greyboxaudio/SIAM-295b/README.md

# SIAM 295b
This design is based on the Siemens W295b Equalizer.
