greyboxaudio/SIAM-295b/SIAM-295b/SIAM-295b.pdf

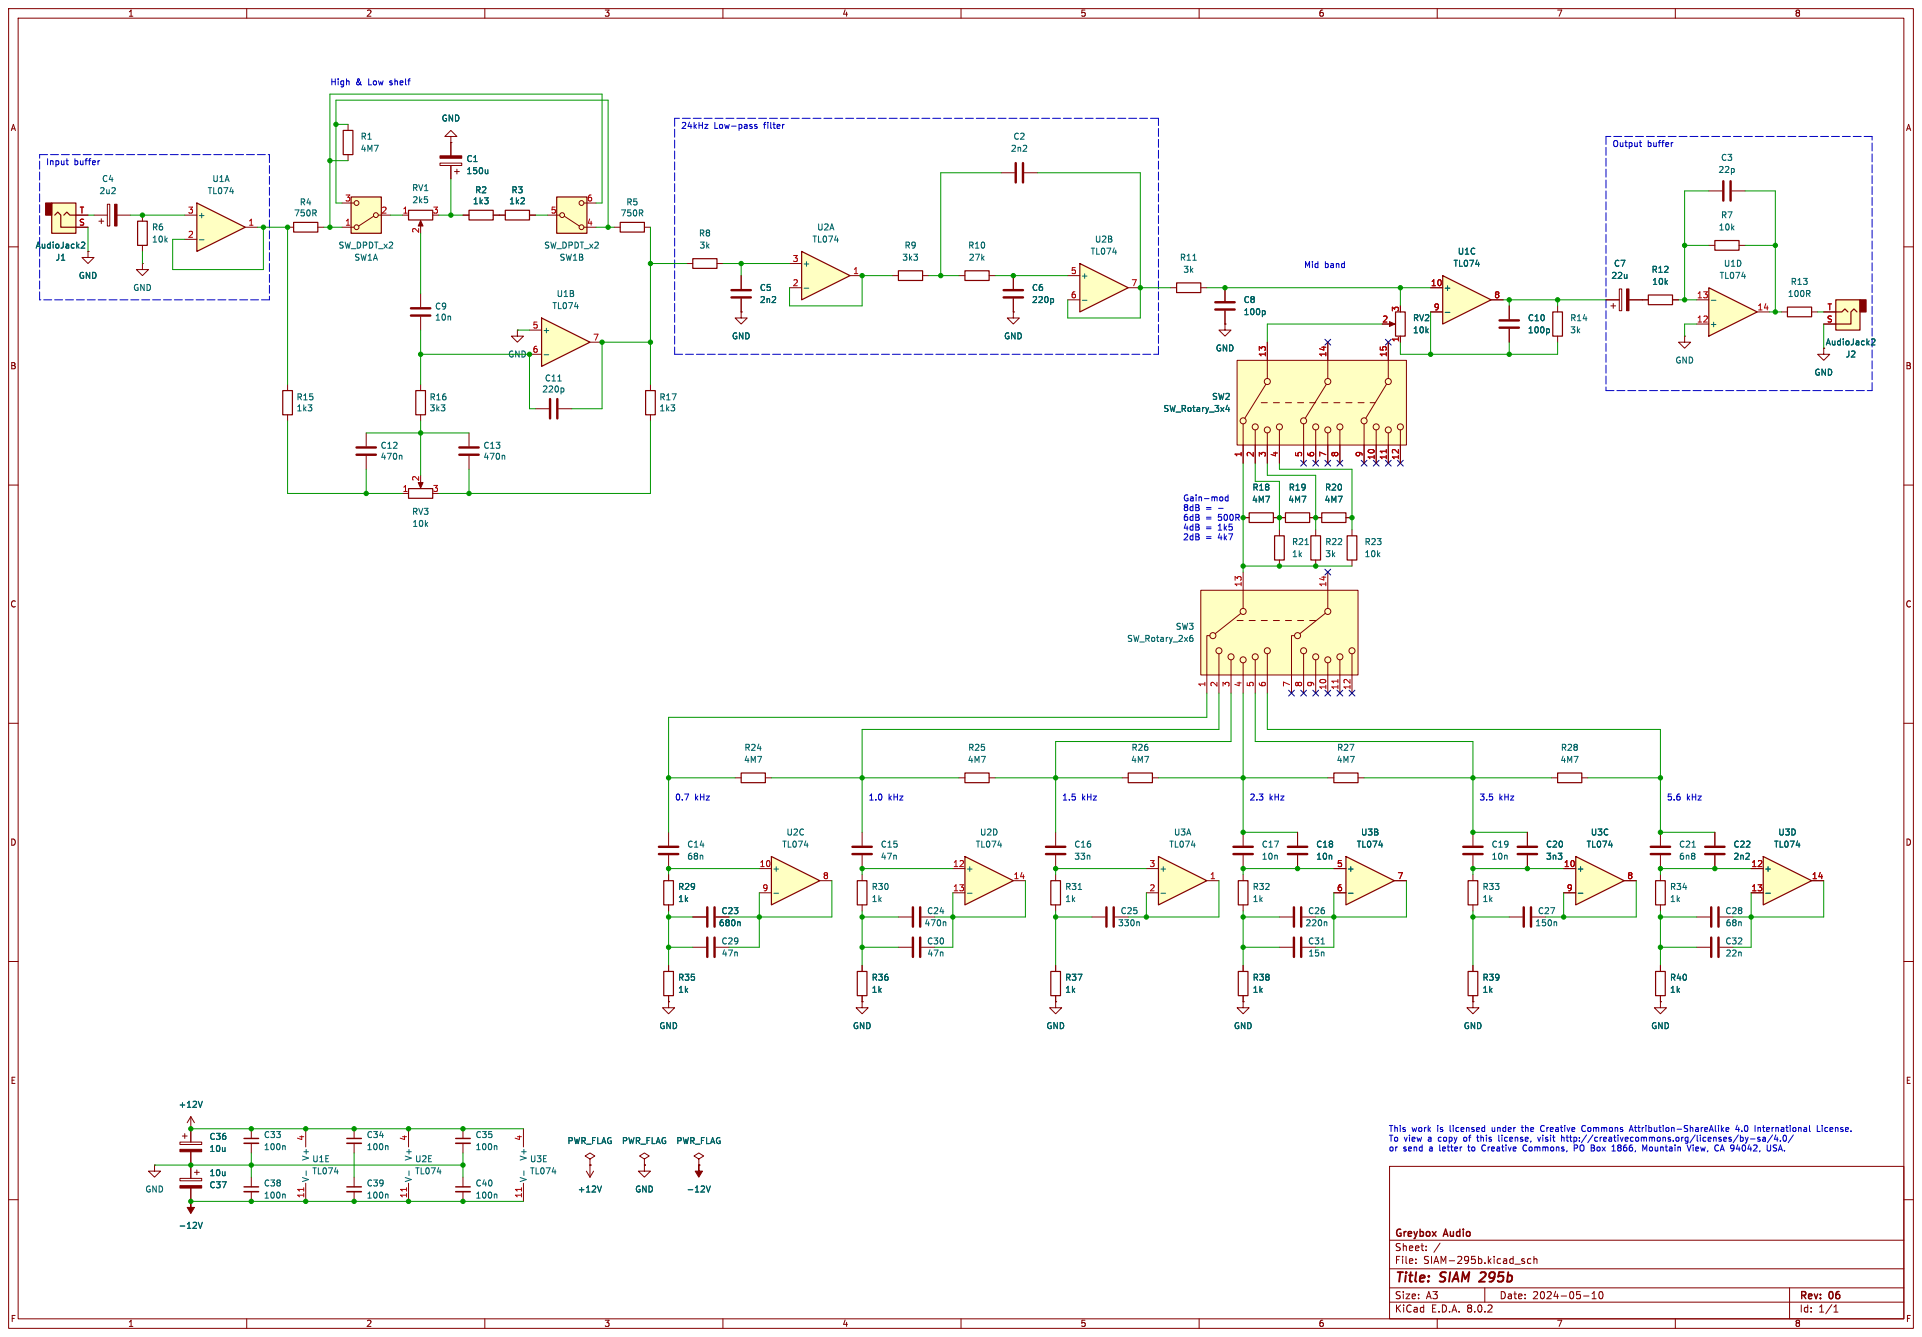
[picture p1: page 1]

File: SIAM-295b.kicad_sch Sheet: / Greybox Audio
