greyboxaudio/SIAM-295b/SIAM-295b/ClassA/siemens/siemens.pdf

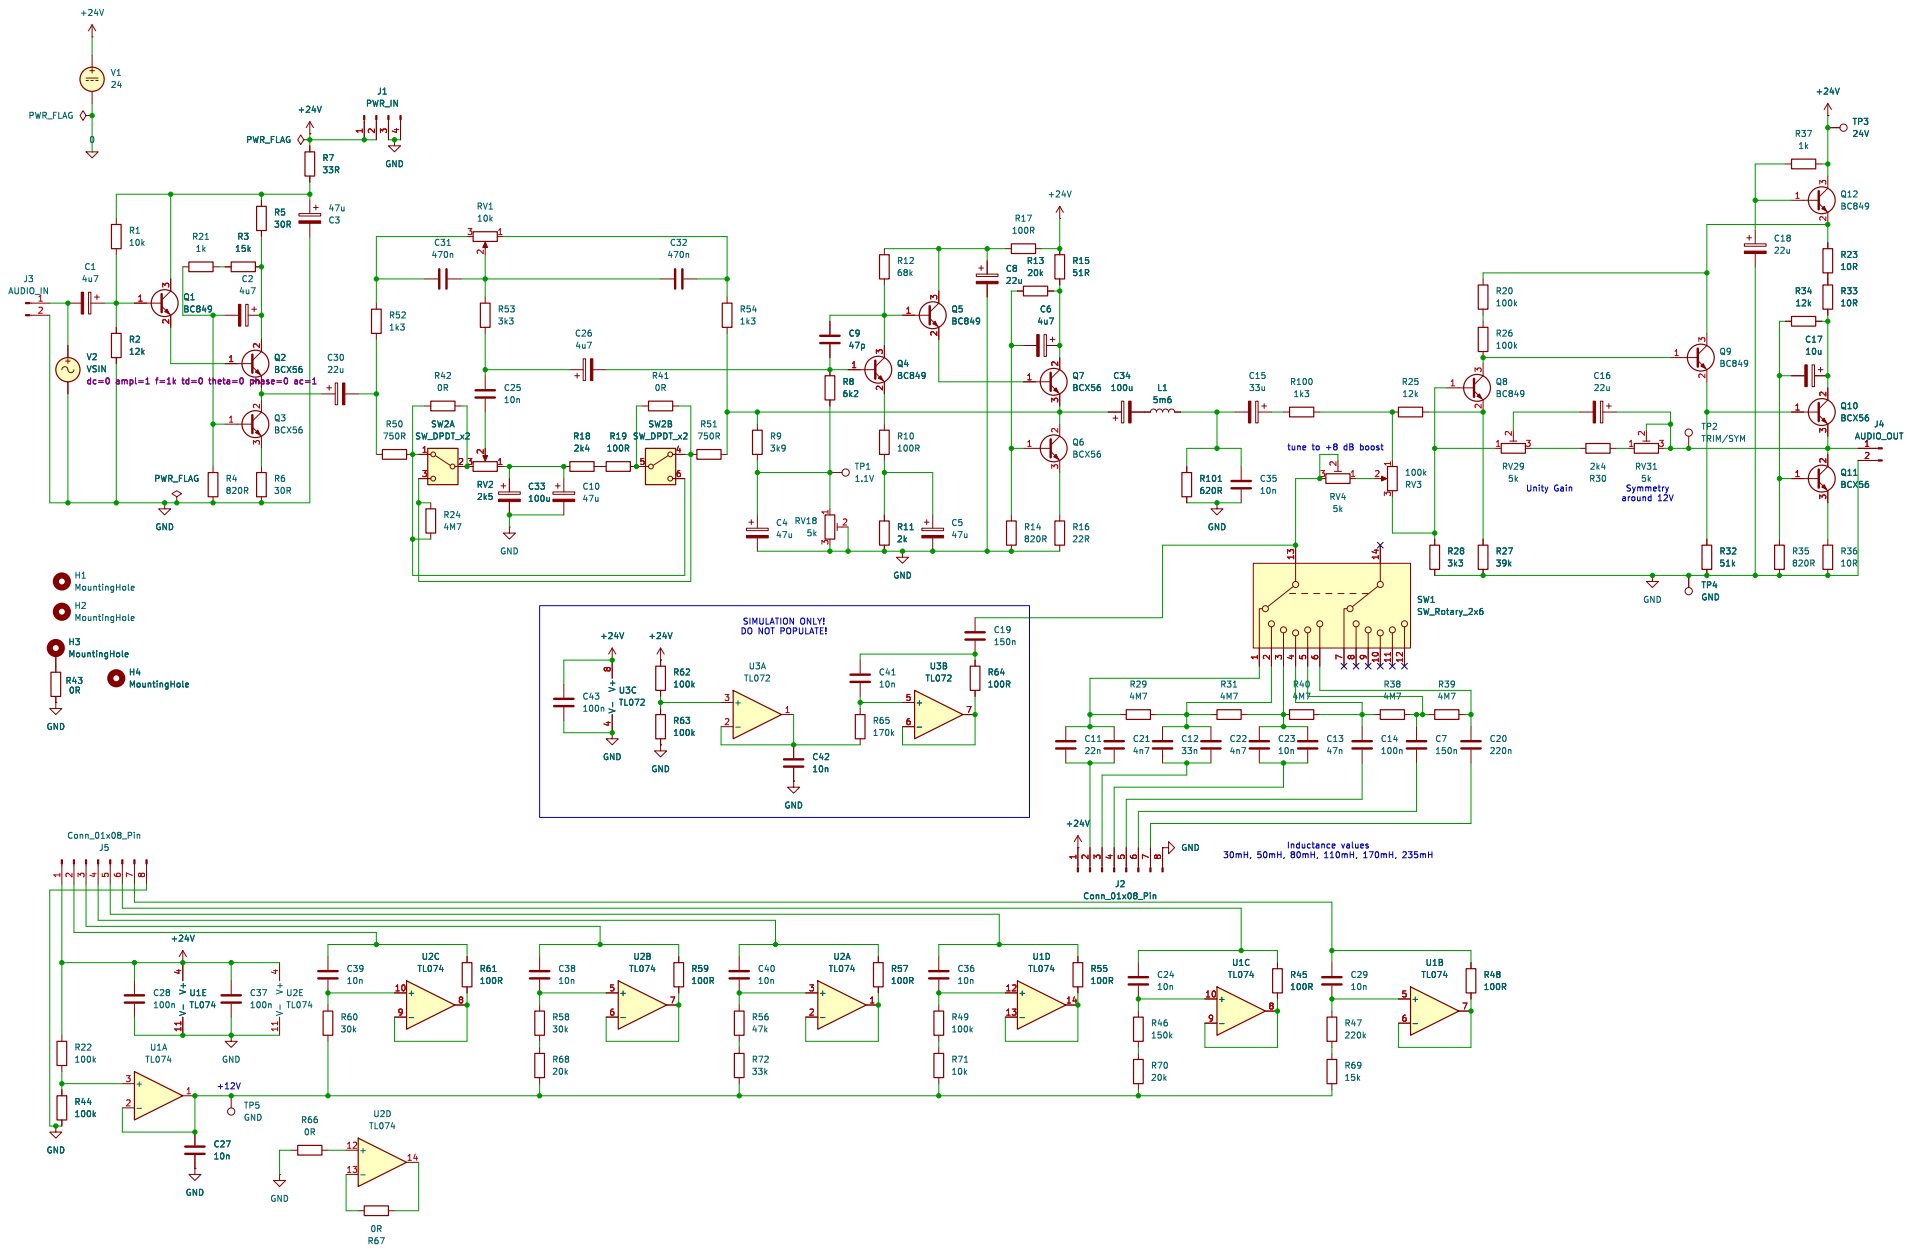
[picture p2: page 1]

tune to +8 dB boost
