greyboxaudio/SIAM-295b/w295b.asc

C1: cap; 4µ7
C2: cap; 56p
C3: cap; 100µ
C4: cap; 22µ
C5: cap; 56µ
C6: cap; 10n
C7: cap; 56µ
C8: cap; 150µ
C9: cap; 25µ
C10: cap; 22µ
C11: cap; 470n
C12: cap; 470n
C13: cap; 10µ
C14: cap; 22µ
C15: cap; 33µ
C16: cap; 10n
C17: cap; {C}
C18: cap; 4µ7
C19: cap; 50µ
C20: cap; 4µ7
C21: cap; 4µ7
C22: cap; 4µ7
C23: cap; 10n
C24: cap; 470n
C25: cap; 470n
C26: cap; 150µ
C27: cap; 2µ2
C28: cap; {C}
C30: cap; 100p
C31: cap; 100p
C32: cap; 220p
C33: cap; 22p
C34: cap; 22p
C35: cap; 2n2
C36: cap; 220p
C37: cap; 2n2
C38: cap; 22µ
C39: cap; {C1}
C40: cap; {C2}
L1: ind; {L}
L2: ind; 6m
L3: ind; {L}
Q1: npn
Q2: npn
Q3: npn
Q4: npn
Q5: npn
Q6: npn
Q7: npn
Q8: npn
Q9: npn
Q10: npn
Q11: npn
Q12: npn
R1: res; 6k2
R2: res; 3k9
R3: res; {TR1}
R4: res; 100
R5: res; 12k
R6: res; 2k
R7: res; 68k
R8: res; 1
R9: res; 100
R10: res; 22
R11: res; 820
R12: res; 200k
R13: res; 20k
R14: res; 51
R15: res; 10k
R16: res; 30
R17: res; 820
R18: res; 16k
R19: res; 39k
R20: res; 30
R21: res; 750
R22: res; 2530
R23: res; 1
R24: res; 750
R25: res; 3k3
R26: res; 1k3
R27: res; 1k3
R28: res; 5k
R29: res; 5k
R30: res; 3k3
R31: res; {TR2a}
R32: res; {TR2b}
R33: res; 2k4
R34: res; {TR3}
R35: res; 51k
R36: res; 20
R37: res; 12k
R38: res; 820
R39: res; 10
R40: res; 1k
R41: res; 510k
R42: res; 510k
R43: res; 1k3
R44: res; 620
R45: res; {G}
R46: res; 30
R47: res; 12k
R48: res; 10k
R49: res; 10k
R50: res; 100
R51: res; 750
R52: res; 2k5
R53: res; 1
R54: res; 750
R55: res; 3k3
R56: res; 1k3
R57: res; 1k3
R58: res; 5k
R59: res; 5k
R60: res; 1
R61: res; 10k
R62: res; {VR1}; tol=1 pwr=0.25
R63: res; {VR2}; tol=1 pwr=0.25
R64: res; {G1}
R65: res; 680
R67: res; {G1}
R68: res; 10k
R69: res; 10k
R70: res; 100
R71: res; 2k5
R72: res; 2530
R73: res; 1
R74: res; 3k
R75: res; 3k3
R76: res; {Q}
R77: res; 27k
R78: res; 1k
R79: res; 1k
U1: ADTL082
U2: ADTL082
U3: ADTL082
U4: ADTL082
U5: ADTL082
U7: ADTL082
U8: ADTL082
U9: ADTL082
V1: voltage; 12
V2: voltage; -12
V3: voltage; 24
V5: voltage; SINE(0 1 1000 0 0 0 1000); AC 1
Named nets: 0, V+, V-, 24V, siemens, SIAM
;ac dec 100 10 24k
Inductance
0,7 kHz = 235mH
1,0 kHz = 170mH
1.5 kHz = 110mH
2.3 kHz = 80mH
3.5 kHz = 53mH
5.6 kHz = 30mH
.param TR1=440 TR2a=1580 TR2b=3320 TR3=3840
Capacitance
0,7 kHz = 220nF
1,0 kHz = 150nF
1.5 kHz = 100nF
2.3 kHz = 60nF
3.5 kHz = 39nF
5.6 kHz = 27nF
Gain
+2dB = 3k7
+4dB = 1k6
+6dB = 910
+8dB = 580
 
-2dB = 4k9
-4dB = 2k1
-6dB = 1k3
-8dB = 850
;step param G list 3k7 1k6 910 570
;step param G list 4k9 2k1 1k3 830
1.1V
DC offset
DC Bias point
Q-Mod
8db = 1
6db = 500R
4db = 1k5
2db = 4k7
#Ideal Capacitances
#0.7 kHz = 66n9 / 773n
#1.0 kHz = 46n8 / 541n
#1.5 kHz = 31n2 / 361n
#2.3 kHz = 20n4 / 235n
#3.5 kHz = 13n4 / 155n
#5.6 kHz = 8n4 / 97n
.param G=580
.param C=27n L=30m C1=9n C2=90n
Rounded Values
0,7 kHz = 133n / 3n3 / 118k
1,0 kHz = 100n / 2n2 / 115k
1.5 kHz = 68n / 1n5 / 110k
2.3 kHz = 43n / 1n / 111k
3.5 kHz = 25n / 680p / 120k
5.6 kHz = 15n / 470p / 115k
.param VR1=10k VR2=1
.param Q=1
.ac dec 101 200 20k
;noise V(SIAM) V3 oct 24 10 24k
.param G1=3000
