greyboxaudio/SIAM-295b/SIAM-295b/ClassA/siemens/siemens.kicad_pcb

## KiCad design SIAM-295b/ClassA/siemens/siemens.kicad_pcb (2025-08-25)

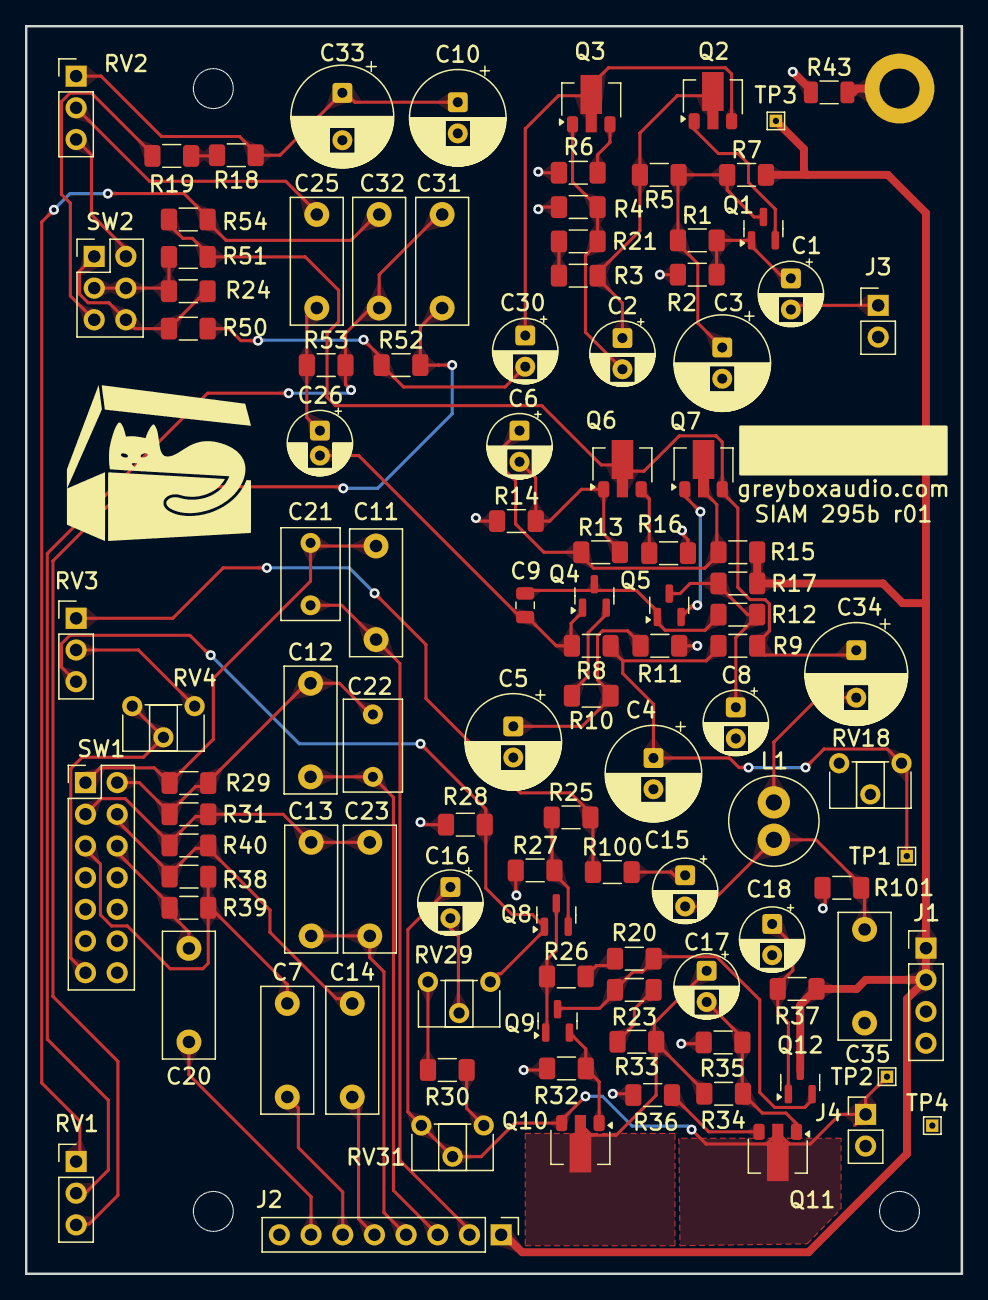
[picture p3: board siemens.kicad_pcb from above]

Board: 2 copper layers, 75.0 x 100.0 mm, 111 parts (0 on the bottom side), 68 nets.

Parts:
C1, C2, C6: 4u7; CP_Radial_D5.0mm_P2.50mm
C3, C4, C5, C10: 47u; CP_Radial_D7.5mm_P2.50mm
C7: 150n; C_Rect_L10.0mm_W4.0mm_P7.50mm_MKS4
C8, C16, C18, C30: 22u; CP_Radial_D5.0mm_P2.50mm
C9: 47p; C_0805_2012Metric
C11: 22n; C_Rect_L10.0mm_W4.0mm_P7.50mm_MKS4
C12: 33n; C_Rect_L10.0mm_W4.0mm_P7.50mm_MKS4
C13: 47n; C_Rect_L10.0mm_W4.0mm_P7.50mm_MKS4
C14: 100n; C_Rect_L10.0mm_W4.0mm_P7.50mm_MKS4
C15: 33u; CP_Radial_D5.0mm_P2.50mm
C17: 10u; CP_Radial_D5.0mm_P2.50mm
C20: 220n; C_Rect_L10.0mm_W4.0mm_P7.50mm_MKS4
C21, C22: 4n7; C_Rect_L7.2mm_W4.5mm_P5.00mm_FKS2_FKP2_MKS2_MKP2
C23, C25, C35: 10n; C_Rect_L10.0mm_W4.0mm_P7.50mm_MKS4
C26: 4u7; CP_Radial_D5.0mm_P2.00mm
C31, C32: 470n; C_Rect_L10.0mm_W4.0mm_P7.50mm_MKS4
C33, C34: 100u; CP_Radial_D8.0mm_P3.80mm
H1, H2, H4: MountingHole; MountingHole_3.2mm_M3_DIN965
H3: MountingHole; MountingHole_3.2mm_M3_DIN965_Pad
J1: PWR_IN; PinHeader_1x04_P2.54mm_Vertical
J2: Conn_01x08_Pin; PinHeader_1x08_P2.54mm_Vertical
J3: AUDIO_IN; PinHeader_1x02_P2.54mm_Vertical
J4: AUDIO_OUT; PinHeader_1x02_P2.54mm_Vertical
L1: 5m6; L_Radial_D7.0mm_P3.00mm
Q1, Q4, Q5, Q8, Q9, Q12: BC849; SOT-23
Q2, Q3, Q6, Q7, Q10, Q11: BCX56; SOT-89-3
R1: 10k; R_1206_3216Metric_Pad1.30x1.75mm_HandSolder
R2, R25, R34: 12k; R_1206_3216Metric_Pad1.30x1.75mm_HandSolder
R3: 15k; R_1206_3216Metric_Pad1.30x1.75mm_HandSolder
R4, R14, R35: 820R; R_1206_3216Metric_Pad1.30x1.75mm_HandSolder
R5, R6: 30R; R_1206_3216Metric_Pad1.30x1.75mm_HandSolder
R7: 33R; R_1206_3216Metric_Pad1.30x1.75mm_HandSolder
R8: 6k2; R_1206_3216Metric_Pad1.30x1.75mm_HandSolder
R9: 3k9; R_1206_3216Metric_Pad1.30x1.75mm_HandSolder
R10, R17, R19: 100R; R_1206_3216Metric_Pad1.30x1.75mm_HandSolder
R11: 2k; R_1206_3216Metric_Pad1.30x1.75mm_HandSolder
R12: 68k; R_1206_3216Metric_Pad1.30x1.75mm_HandSolder
R13: 20k; R_1206_3216Metric_Pad1.30x1.75mm_HandSolder
R15: 51R; R_1206_3216Metric_Pad1.30x1.75mm_HandSolder
R16: 22R; R_1206_3216Metric_Pad1.30x1.75mm_HandSolder
R18, R30: 2k4; R_1206_3216Metric_Pad1.30x1.75mm_HandSolder
R20, R26: 100k; R_1206_3216Metric_Pad1.30x1.75mm_HandSolder
R21, R37: 1k; R_1206_3216Metric_Pad1.30x1.75mm_HandSolder
R23, R33, R36: 10R; R_1206_3216Metric_Pad1.30x1.75mm_HandSolder
R24, R29, R31, R38, R39, R40: 4M7; R_1206_3216Metric_Pad1.30x1.75mm_HandSolder
R27: 39k; R_1206_3216Metric_Pad1.30x1.75mm_HandSolder
R28, R53: 3k3; R_1206_3216Metric_Pad1.30x1.75mm_HandSolder
R32: 51k; R_1206_3216Metric_Pad1.30x1.75mm_HandSolder
R43: 0R; R_1206_3216Metric
R50, R51: 750R; R_1206_3216Metric_Pad1.30x1.75mm_HandSolder
R52, R54, R100: 1k3; R_1206_3216Metric_Pad1.30x1.75mm_HandSolder
R101: 620R; R_1206_3216Metric_Pad1.30x1.75mm_HandSolder
RV1: 10k; PinHeader_1x03_P2.54mm_Vertical
RV2: 2k5; PinHeader_1x03_P2.54mm_Vertical
RV3: 100k; PinHeader_1x03_P2.54mm_Vertical
RV4, RV18, RV29, RV31: 5k; Potentiometer_ACP_CA6-H2,5_Horizontal
SW1: SW_Rotary_2x6; PinHeader_2x07_P2.54mm_Vertical
SW2: SW_DPDT_x2; PinHeader_2x03_P2.54mm_Vertical
TP1: 1.1V; TestPoint_THTPad_1.0x1.0mm_Drill0.5mm
TP2: TRIM/SYM; TestPoint_THTPad_1.0x1.0mm_Drill0.5mm
TP3: 24V; TestPoint_THTPad_1.0x1.0mm_Drill0.5mm
TP4: GND; TestPoint_THTPad_1.0x1.0mm_Drill0.5mm

Connections:
+24V: J1.1, J1.2, J2.1, Q12.3 (C), R7.2, R15.2, R17.1, R37.1, TP3.1
GND: C3.2, C4.2, C5.2, C8.2, C10.2, C18.2, C33.2, C35.2, J1.3, J1.4, J2.8, J3.2, J4.2, R2.2, R4.1, R6.1, R11.1, R14.1, R16.1, R27.1, R28.1, R32.1, R35.1, R36.1, R43.2, R101.2, RV18.2, RV18.3, TP4.1
unnamed: C4.1, R8.1, R9.1, RV18.1, TP1.1
unnamed: C5.1, R10.1, R11.2
unnamed: C7.1, R38.1, R39.2, SW1.5
unnamed: C10.1, C33.1, R18.1, RV2.1
unnamed: C11.2, C21.2, R29.2, SW1.1
unnamed: C12.1, C22.2, R29.1, R31.2, SW1.2
unnamed: C13.1, C23.2, R31.1, R40.2, SW1.3
unnamed: C14.1, R38.2, R40.1, SW1.4
unnamed: C15.1, R100.2
unnamed: C15.2, C35.1, L1.2, R101.1
unnamed: C16.2, RV29.2
unnamed: C20.1, R39.1, SW1.6
unnamed: C25.1, RV2.2
unnamed: C25.2, C26.1, R53.1
unnamed: C30.2, R50.1, R52.1
unnamed: C31.1, R52.2, RV1.3
unnamed: C31.2, C32.1, R53.2, RV1.2
unnamed: C32.2, R54.2, RV1.1
unnamed: C34.2, L1.1
unnamed: H3.1, R43.1
unnamed: C11.1, C21.1, J2.2
unnamed: C12.2, C22.1, J2.3
unnamed: C13.2, C23.1, J2.4
unnamed: C14.2, J2.5
unnamed: C7.2, J2.6
unnamed: C20.2, J2.7
unnamed: C1.2, J3.1
unnamed: C16.1, J4.1, Q10.3 (E), Q11.2 (C), RV31.2, RV31.3, TP2.1
unnamed: C1.1, Q1.1 (B), R1.2, R2.1
unnamed: C3.1, Q1.3 (C), R1.1, R5.2, R7.1
unnamed: Q1.2 (E), Q2.1 (B)
unnamed: C2.1, Q2.2 (C), R3.2, R5.1
unnamed: C30.1, Q2.3 (E), Q3.2 (C)
unnamed: C2.2, Q3.1 (B), R4.2, R21.1
unnamed: Q3.3 (E), R6.2
unnamed: C9.2, C26.2, Q4.1 (B), R8.2
unnamed: C9.1, Q4.3 (C), Q5.1 (B), R12.1
unnamed: Q4.2 (E), R10.2
unnamed: C8.1, Q5.3 (C), R12.2, R17.2
unnamed: Q5.2 (E), Q7.1 (B)
unnamed: C6.2, Q6.1 (B), R13.2, R14.2
unnamed: C34.1, Q6.2 (C), Q7.3 (E), R9.2, R51.2, R54.1
unnamed: Q6.3 (E), R16.2
unnamed: C6.1, Q7.2 (C), R13.1, R15.1
unnamed: Q8.1 (B), R28.2, RV3.3, RV29.1
unnamed: Q8.3 (C), Q9.1 (B), R26.1
unnamed: Q8.2 (E), R25.1, R27.2
unnamed: Q9.2 (E), Q10.1 (B), R32.2
unnamed: C17.1, Q10.2 (C), R33.1, R34.1
unnamed: C17.2, Q11.1 (B), R34.2, R35.2
unnamed: Q11.3 (E), R36.2
unnamed: C18.1, Q12.1 (B), R37.2
unnamed: Q9.3 (C), Q12.2 (E), R20.2, R23.2
unnamed: R18.2, R19.1
unnamed: R20.1, R26.2
unnamed: R3.1, R21.2
unnamed: R23.1, R33.2
unnamed: R30.1, RV31.1
unnamed: R30.2, RV29.3
unnamed: R25.2, R100.1, RV3.1
unnamed: RV3.2, RV4.1
unnamed: RV4.2, RV4.3, SW1.13
unnamed: R24.1, R50.2, SW2.1 (A), SW2.6 (C)
unnamed: RV2.3, SW2.2 (B)
unnamed: R24.2, R51.1, SW2.3 (C), SW2.4 (A)
unnamed: R19.2, SW2.5 (B)
