greyboxaudio/SIAM-295b/SIAM-295b/SIAM-295b.kicad_pcb

## KiCad design SIAM-295b/SIAM-295b.kicad_pcb (2023-01-07)

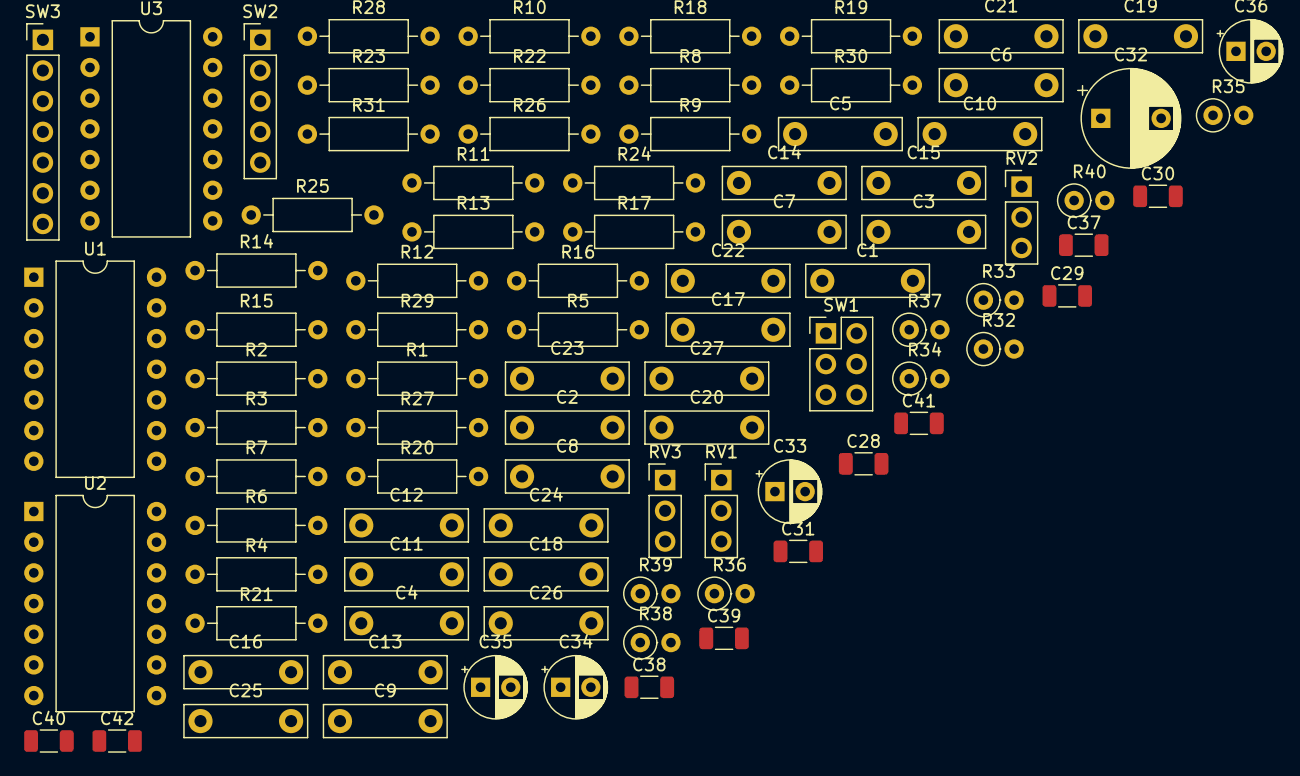
[picture p4: board SIAM-295b.kicad_pcb from above]

Board: 2 copper layers, 91 parts (0 on the bottom side), 56 nets, no tracks yet.

Parts:
C1, C3, C10: 470n; C_Rect_L10.0mm_W2.5mm_P7.50mm_MKS4
C2, C16, C19, C20: 10n; C_Rect_L10.0mm_W2.5mm_P7.50mm_MKS4
C4, C11, C26: 68n; C_Rect_L10.0mm_W2.5mm_P7.50mm_MKS4
C5: 680n; C_Rect_L10.0mm_W2.5mm_P7.50mm_MKS4
C6, C9, C22: 47n; C_Rect_L10.0mm_W2.5mm_P7.50mm_MKS4
C7: 4n7; C_Rect_L10.0mm_W2.5mm_P7.50mm_MKS4
C8, C13, C27: 2n2; C_Rect_L10.0mm_W2.5mm_P7.50mm_MKS4
C12: 220p; C_Rect_L10.0mm_W2.5mm_P7.50mm_MKS4
C14: 33n; C_Rect_L10.0mm_W2.5mm_P7.50mm_MKS4
C15: 330n; C_Rect_L10.0mm_W2.5mm_P7.50mm_MKS4
C17: 220n; C_Rect_L10.0mm_W2.5mm_P7.50mm_MKS4
C18: 15n; C_Rect_L10.0mm_W2.5mm_P7.50mm_MKS4
C21: 100n; C_Rect_L10.0mm_W2.5mm_P7.50mm_MKS4
C23: 3n3; C_Rect_L10.0mm_W2.5mm_P7.50mm_MKS4
C24: 6n8; C_Rect_L10.0mm_W2.5mm_P7.50mm_MKS4
C25: 22n; C_Rect_L10.0mm_W2.5mm_P7.50mm_MKS4
C28, C29: 100p; C_1206_3216Metric
C30: 220p; C_1206_3216Metric
C31: 22p; C_1206_3216Metric
C32: 150u; CP_Radial_D8.0mm_P5.00mm
C33: 2u2; CP_Radial_D5.0mm_P2.50mm
C34: 22u; CP_Radial_D5.0mm_P2.50mm
C35, C36: 10u; CP_Radial_D5.0mm_P2.50mm
C37, C38, C39, C40, C41, C42: 100n; C_1206_3216Metric
R1, R4, R7: 1k3; R_Axial_DIN0207_L6.3mm_D2.5mm_P10.16mm_Horizontal
R2, R6: 750R; R_Axial_DIN0207_L6.3mm_D2.5mm_P10.16mm_Horizontal
R3, R13: 3k3; R_Axial_DIN0207_L6.3mm_D2.5mm_P10.16mm_Horizontal
R5: 1k2; R_Axial_DIN0207_L6.3mm_D2.5mm_P10.16mm_Horizontal
R8, R9, R11, R12, R15, R16, R18, R19, R20, R23, R24, R26, R27: 1k; R_Axial_DIN0207_L6.3mm_D2.5mm_P10.16mm_Horizontal
R10, R17, R21, R25: 3k; R_Axial_DIN0207_L6.3mm_D2.5mm_P10.16mm_Horizontal
R14: 27k; R_Axial_DIN0207_L6.3mm_D2.5mm_P10.16mm_Horizontal
R22, R28, R29, R30: 10k; R_Axial_DIN0207_L6.3mm_D2.5mm_P10.16mm_Horizontal
R31: 100R; R_Axial_DIN0207_L6.3mm_D2.5mm_P10.16mm_Horizontal
R32, R33, R34, R35, R36, R37, R38, R39, R40: 4M7; R_Axial_DIN0207_L6.3mm_D2.5mm_P2.54mm_Vertical
RV1: 2k5; PinHeader_1x03_P2.54mm_Vertical
RV2, RV3: 10k; PinHeader_1x03_P2.54mm_Vertical
SW1: SW_DPDT_x2; PinHeader_2x03_P2.54mm_Vertical
SW2: SW_Rotary3x4; PinHeader_1x05_P2.54mm_Vertical
SW3: SW_Rotary2x6; PinHeader_1x07_P2.54mm_Vertical
U1, U2, U3: TL074; DIP-14_W10.16mm

Connections:
+12V: C35.1, C37.1, C39.1, C41.1, U1.4 (V+), U2.4 (V+), U3.4 (V+)
-12V: C36.2, C38.1, C40.1, C42.1, U1.11 (V-), U2.11 (V-), U3.11 (V-)
GND: C8.2, C12.2, C28.2, C32.2, C35.2, C36.1, C37.2, C38.2, C39.2, C40.2, C41.2, C42.2, R9.2, R12.2, R16.2, R19.2, R24.2, R27.2, R28.2, U1.5 (+), U1.12 (+)
unnamed: C1.1, C3.1, R3.2, RV3.2
unnamed: C1.2, R1.2, RV3.1
unnamed: C2.1, RV1.2
unnamed: C2.2, C30.1, R3.1, U1.6 (-)
unnamed: C3.2, R7.2, RV3.3
unnamed: C4.1, C7.1, R36.1, SW3.1
unnamed: C4.2, C7.2, R8.1, U2.10 (+)
unnamed: C5.1, C6.1, R8.2, R9.1
unnamed: C5.2, C6.2, U2.8, U2.9 (-)
unnamed: C8.1, R10.1, U2.3 (+)
unnamed: C9.1, R36.2, R37.1, SW3.2
unnamed: C9.2, R11.1, U2.12 (+)
unnamed: C10.1, C11.1, R11.2, R12.1
unnamed: C10.2, C11.2, U2.13 (-), U2.14
unnamed: C12.1, R14.1, U2.5 (+)
unnamed: C13.1, R13.1, R14.2
unnamed: C13.2, R17.2, U2.6 (-), U2.7
unnamed: C14.1, R37.2, R38.1, SW3.3
unnamed: C14.2, R15.1, U3.3 (+)
unnamed: C15.1, R15.2, R16.1
unnamed: C15.2, U3.1, U3.2 (-)
unnamed: C16.1, C19.1, R38.2, R39.1, SW3.4
unnamed: C16.2, C19.2, R18.1, U3.5 (+)
unnamed: C17.1, C18.1, R18.2, R19.1
unnamed: C17.2, C18.2, U3.6 (-), U3.7
unnamed: C20.1, C23.1, R39.2, R40.1, SW3.5
unnamed: C20.2, C23.2, R23.1, U3.10 (+)
unnamed: C21.1, C22.1, R23.2, R24.1
unnamed: C21.2, C22.2, U3.8, U3.9 (-)
unnamed: C24.1, C27.1, R40.2, SW3.6
unnamed: C24.2, C27.2, R26.1, U3.12 (+)
unnamed: C25.1, C26.1, R26.2, R27.1
unnamed: C25.2, C26.2, U3.13 (-), U3.14
unnamed: C28.1, R17.1, RV2.3, U1.10 (+)
unnamed: C29.1, C34.1, R25.1, U1.8
unnamed: C29.2, R25.2, RV2.1, U1.9 (-)
unnamed: C30.2, R6.2, R7.1, R10.2, U1.7
unnamed: C31.1, R29.1, R30.2, U1.13 (-)
unnamed: C31.2, R30.1, R31.2, U1.14
unnamed: C32.1, R4.1, RV1.3
unnamed: C33.2, R28.1, U1.3 (+)
unnamed: C34.2, R29.2
unnamed: R1.1, R2.1, U1.1, U1.2 (-)
unnamed: R2.2, R32.1, SW1.1 (A), SW1.6 (C)
unnamed: R4.2, R5.1
unnamed: R5.2, SW1.5 (B)
unnamed: R13.2, U2.1, U2.2 (-)
unnamed: R20.1, R33.2, R34.1, SW2.2
unnamed: R20.2, R21.2, R22.2, R33.1, SW2.1
unnamed: R21.1, R34.2, R35.1, SW2.3
unnamed: R22.1, R35.2, SW2.4
unnamed: R6.1, R32.2, SW1.3 (C), SW1.4 (A)
unnamed: RV1.1, SW1.2 (B)
