greyboxaudio/SIAM-295b/(commit log)

2022-03-27 updated schematic
    [Funkhaus-295.kicad_sch]
2022-03-29 added Q-Mod circuit, changed project name
    [Funkhaus-295.kicad_sch]
2022-03-30 update circuit simulation
2022-08-07 updated schematic
    rev 05
    [Funkhaus-295.kicad_sch]
2022-08-07 Rev 05a
    - added a missing OpAmp
    - added a cat
    [Funkhaus-295.kicad_sch]
2022-08-08 Rev 05c
    corrected the orientation of several opamps
    [Funkhaus-295.kicad_sch]
2022-08-14 housekeeping (Rev05C)
    - corrected missing 10K resistor
    - added output capacitor
    - added annotations
    - changed component numbering to make a little more sense
    - added partial component footprints
    [Funkhaus-295.kicad_sch]
2022-08-14 fixed C35/C36 Symbol
    fixed C35/C36 Symbol
    [Funkhaus-295.kicad_sch]
2022-08-14 removed redundant 4M7 resistors
    [Funkhaus-295.kicad_sch, SIAM_295b_BoM.ods]
2022-09-10 fixed RV1 wiring
    [Funkhaus-295.kicad_sch]
2023-01-07 update footprints, started pcb
    [Funkhaus-295.kicad_pcb, Funkhaus-295.kicad_sch]
2024-03-18 updated schematic for kicad 8.0
    [Funkhaus-295.kicad_sch]
2024-05-10 update schematic
    [SIAM-295b.kicad_pcb, SIAM-295b.kicad_sch, SIAM_295b_BoM.ods]
2024-05-10 moved files
    [SIAM-295b.kicad_pcb, SIAM-295b.kicad_sch, SIAM_295b_BoM.ods]
2024-05-10 remove old files
    [Funkhaus-295.kicad_pcb, Funkhaus-295.kicad_sch, SIAM-295b.kicad_sch, SIAM_295b_BoM.ods]
2025-07-11 class A
    added schematic for a THT discrete Class A build (work in progress)
    [siemens.csv, siemens.kicad_pcb, siemens.kicad_sch, siemens_simulation.kicad_sch]
2025-07-11 started pcb
    [siemens.kicad_pcb, siemens.kicad_sch]
2025-07-12 update pcb
    [siemens.kicad_pcb]
2025-08-16 update pcb
    switch transistors & resistors to smd
    [siemens.kicad_pcb, siemens.kicad_sch]
2025-08-16 update pcb
    successfully routed all components
    [siemens.kicad_pcb, siemens.kicad_sch]
2025-08-17 update ocb
    added mounting holes, reduced width
    [siemens.kicad_pcb, siemens.kicad_sch]
2025-08-17 update & fab
    updated pcb, added fabrication output
    [siemens-B_Cu.gbl, siemens-B_Mask.gbs, siemens-B_Paste.gbp, siemens-B_Silkscreen.gbo, siemens-Edge_Cuts.gm1, siemens-F_Cu.gtl, siemens-F_Mask.gts, siemens-F_Paste.gtp]
2025-08-19 added gyrator circuits
    includes simulation
    [siemens.kicad_sch]
2025-08-19 updated footprints
    [siemens.kicad_sch]
2025-08-25 update pcb
    added thermal realief for Q10/11, increased spacing for larger trim potentiometer footprints
    [siemens.kicad_pcb]
