greyboxaudio/SIAM-295b/(notices)

Notices in the files:
SIAM-295b/SIAM-295b.kicad_sch:
This work is licensed under the Creative Commons Attribution-ShareAlike 4.0 International License.
To view a copy of this license, visit http://creativecommons.org/licenses/by-sa/4.0
or send a letter to Creative Commons, PO Box 1866, Mountain View, CA 94042, USA.
